plinkysynth/plinky-expander/(threads)

Thread 1 (2022-02-11):

Plinky Expander will not work - please help

noodleboy91, 2022-02-11:
I am wondering if someone can help me out. I built the expander for my Plinky, but it is not lighting up at all, and not being recognized over USB. Looks like it might not be getting power, but I have 10-12v at the power pins on Plinky. Anyone else run into this issue, or know what I should look at next?

mmalex, 2022-02-11:
hi!
sorry to hear that. could i ask - what color plinky board do you have?
could you post photos of the expander underside? where/when did you get the
expander? when you say you see power at the plinky pins, could you also
check at the expander end?
i’ve not seen this issue before so if we can work thru the basics maybe we
can fix it.

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

noodleboy91, 2022-03-17:
I got it to work, ended up being the jumper (did not know if needed to be bridged). Thank you and sorry for the late reply.

Thread 2 (2023-07-07):

PCBway for the touch panel

KeLaiFu, 2023-07-07:
In some of the documentation it mentions using PCBway for the touch panel, and jlc for the rest, is there a reason for this? I would have assumed they both produce boards with the same functionality, however, PCBway is a lot more expensive so I thought I'd check before I get any boards made!

mmalex, 2023-07-07:
sorry, that is confusing! I've used both, and jlc is in general cheaper. they both work :)

mmalex, 2023-07-07:
yeah, the pcbway lacquer seems a bit thicker, and maybe shinier. however I've found that the finish, printing, and color from JLC is really inconsistent - never really bad, per se, but no two runs are even remotely similar. :( so... theres an element of luck I think. (Ive only done one run from pcbway so can't compare their variance)

KeLaiFu, 2023-07-07:
that lines up with what I have seen too. For the record, all the colors apart from black are glossy from jlc, so I may build a nice red plinky.
