plinkysynth/plinky-expander/(commit log)

2021-03-09 first import of expander, proto v2
    [expander.kicad_pcb, expander.sch]
2021-03-09 add jlc bom file
    [jlcbom.csv]
2021-03-09 add first pass of hardware bom
    [hardware-bom.csv]
2021-03-13 output gerber, drill and component position files for JLC assembly. order placed!
    [expander-B_Cu.gbr, expander-B_Mask.gbr, expander-B_Paste.gbr, expander-B_SilkS.gbr, expander-Edge_Cuts.gbr, expander-F_Cu.gbr, expander-F_Mask.gbr, expander-F_Paste.gbr]
2021-03-29 tweak expander to use in-stock jlc parts
    [expander-B_Cu.gbr, expander-B_Mask.gbr, expander-B_Paste.gbr, expander-B_SilkS.gbr, expander-Edge_Cuts.gbr, expander-F_Cu.gbr, expander-F_Mask.gbr, expander-F_Paste.gbr]
2021-03-30 split front and back into separate orders
    [expander_just_back.kicad_pcb, expander_just_front.kicad_pcb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]
